rick-ecircuit/dvm-voltmeter-two-ranges-arduino/protoboard-assembly-connections.JPG

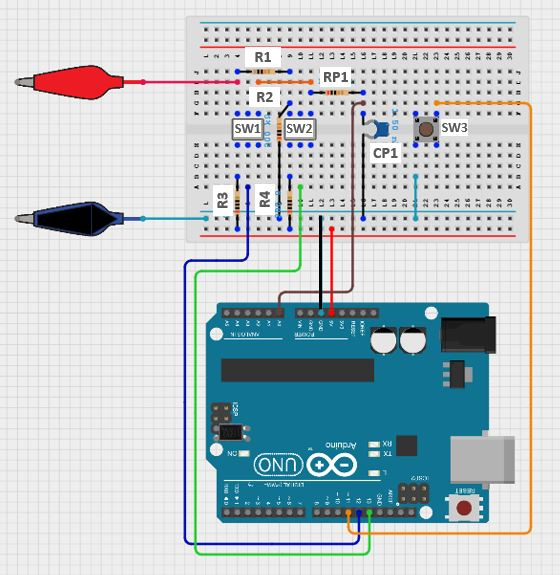
protoboard-assembly-connections.JPG
