rick-ecircuit/dvm-voltmeter-two-ranges-arduino/README.md

# DVM - Design and Build a Two Range Voltmeter using the Arduino.
## Intro

Get hands-on experience with a Digital Voltmeter using
- Resistor Divider
- PhotoMOS Switches
- Low-Pass Filter
- Ardiuno's UNO's ADC

<br>block diagram<br><br>
Check out an overview of the project.  
https://www.instructables.com/Make-a-Two-Range-Voltmeter-DVM-With-Auto-Manual-Ra/  

<br>Specifications
- Two voltage ranges: +4V and +20V.
- Manual (pushbutton) or Auto Range Selection.
- Accuracy
	- 4V Range: Verror = ±15mV ±1.5% of Reading
	- 20V Range: Verror = ±75mV ±1.5% of Reading  

*You can customize the hardware / software for a higher voltage range with the included Design Equations and Excel Calculator.*  

<br>Project Files
- Specifications
- Circuit schematic
- Design equations
- Error Budget Analysis
- Excel calculators
- SPICE simulations
- Flowhart and Arduino code
- Test forms and results tracker  

## Digital Voltmeter Tutorials
>Get Hands-On Experience with 5 Key Design Phases  
>www.ecircuitcenter.com/DVM1/DVM1_series.html

## Project File List
Block Diagram, Schematic, Assembly
- DVM1_block_1.png
- protoboard-schematic.jpg
- protoboard-assembly-connections.jpg

Design Equations
- DVM1_Design_Eqns.pdf

Excel Calculators
- DVM1_Circuit_Design1
- DVM1_Implementation_Strategy1
- DVM1_Offset_Gain_Errors1
- DVM1_-_EBA_Offset_Gain_Errors1

LTSPICE Simulations
- DVM1_basic1.asc
- DVM1_advanced1.asc

Ardiuno Code
- DVM1_flowchart1.jpg
- DVM1_initial_test1.ino
- DVM1_basic_voltmeter1.ino
- DVM1_basic_voltmeter_auto1.ino

Test Forms and Results Tracker
- DVM1_Simulation_Test_Tracker.xlsx
- DVM1_Prototype_Test_Tracker.xlsx

<br>Let me know what you find helpful or any other comments and suggestions. Thanks!  
www.ecircuitcenter.com/contact.htm

Have fun on your next learning / design / coding adventure!

Rick  
eCircuit Center  
https://ecircuitcenter.com/
