rick-ecircuit/dvm-voltmeter-two-ranges-arduino/DVM1_block_1.PNG

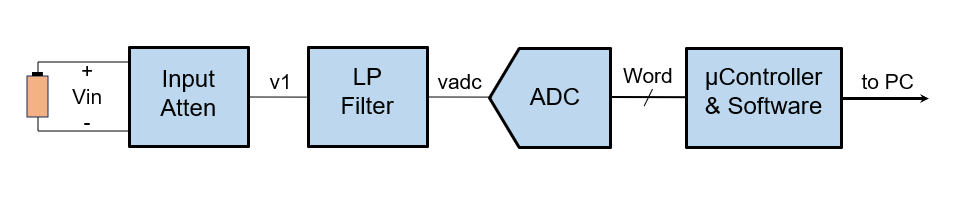
DVM1_block_1.PNG
