rick-ecircuit/dvm-voltmeter-two-ranges-arduino/DVM1_flowchart1.JPG

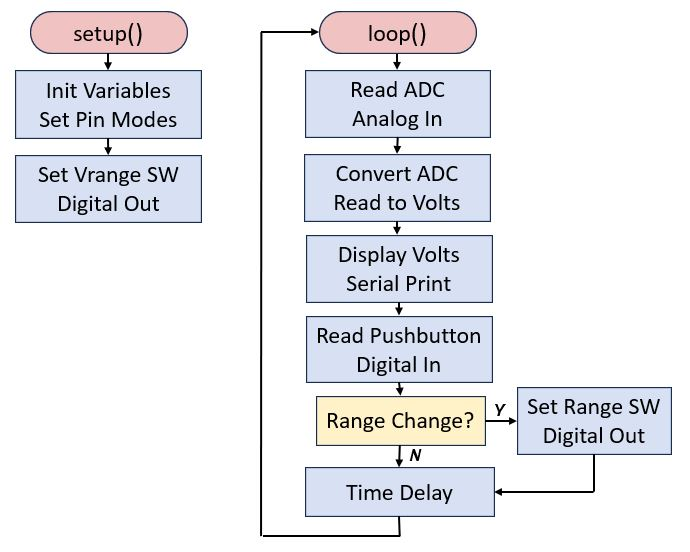
DVM1_flowchart1.JPG
