rick-ecircuit/dvm-voltmeter-two-ranges-arduino/protoboard-schematic.JPG

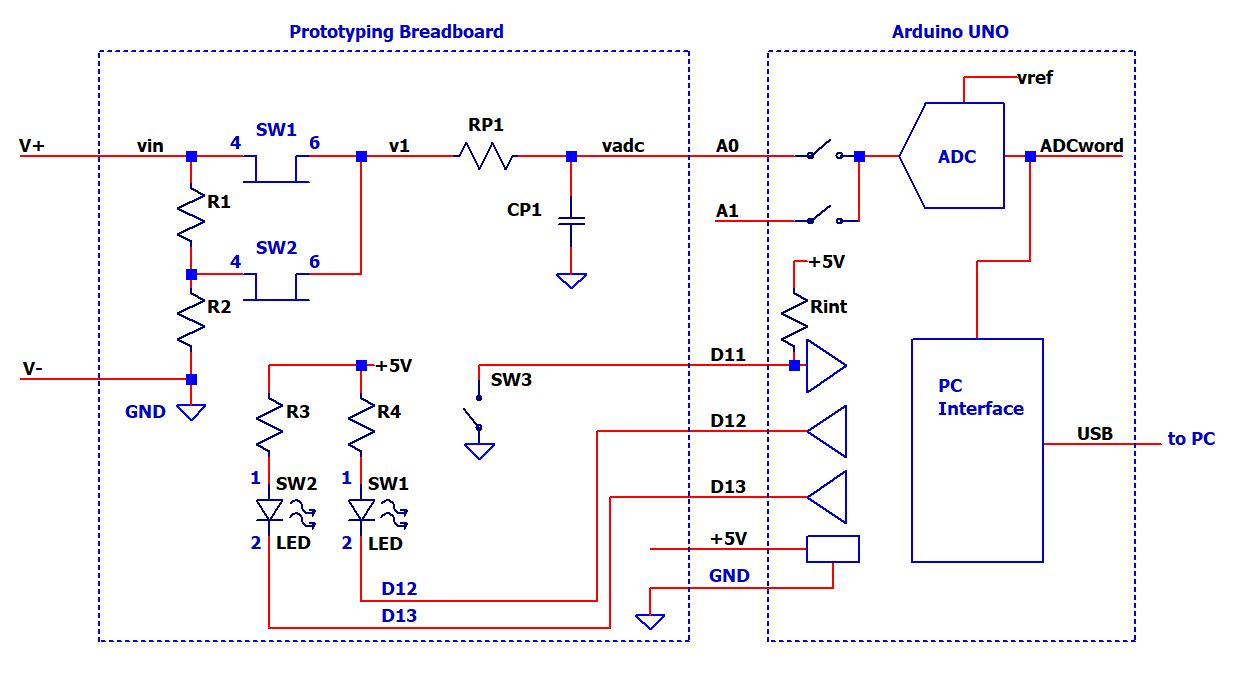
protoboard-schematic.JPG
