rick-ecircuit/dvm-voltmeter-two-ranges-arduino/DVM1_Parts_List.xlsx

DVM1 Parts List
Qty | Ref | Description | Part Number (Digi-key option)
1 |  | Arduino Uno Rev3 Microcontroller Board | A000066
1 |  | USB Cable Type A/B | generic
1 |  | Solderless Breadboard, SparkFun Electronics PRT-12002 | (1568-PRT-12002-ND)
1 pkg |  | Jumper Wires, Various Lengths, M to M, Adafruit Industries | (1528-2185-ND)
2 |  | Test leads, Gator to gator, BLK, RED | generic
2 | SW1,2 | SSR RELAY SPST-NO 500MA 0-60V | TLP592A(F) (TLP592AF-ND)
1 | R1 | RES 806K OHM 0.1%, ≥1/10W | any available
1 | R2 | RES 200K OHM 0.1%, ≥1/10W | any available
1 | RP1 | RES 200K OHM ≤5%, ≥1/10W | any available
1 | CP1 | CAP CER 0.15UF ≥50V, ≤10% X7R | any available
2 | R3,R4 | RES 1K OHM ≤5%, ≥1/10W | any available
1 | SW3 | Push Button, SparkFun Electronics COM-00097 | (1568-COM-00097-ND)
