rick-ecircuit/dvm-voltmeter-two-ranges-arduino/DVM1_advanced1.asc

B_ADC: bv; V=  int(   v(vsh)/v(vrefin) * (2**N)  )
CP1: cap; 0.15µF
Csh: cap; 20pF
DLED1: diode; DLED
DLED2: diode; DLED
R1: res; {R1}
R2: res; {R2}
R3: res; 1k
R4: res; 1k
Rmux: res; 10k
RP1: res; 200k
S_SH: sw; SH
V_D12: voltage; 0V
V_D13: voltage; 5V
V_SH: voltage; PULSE(0V 5V 300ms 10us 10us 1ms 400ms); AC 0V
VCC: voltage; 5V; AC 0V
VIN: voltage; PWL(0us 0V 1us 1.5V)
VLED1: voltage; 0V
VLED2: voltage; 0V
VREF: voltage; {Vref}
W_SW1: csw; VLED1; MOS
W_SW2: csw; VLED2; MOS
Named nets: 0, vin, v1, vsh, adc_word, vrefin, vadc, vcc, vled1, vd1, D12, vmux, v_sh, D13, vled2, vd2
DVM1 Level 2
V+
V-
.tran 0.4s
.param N=10 Vref=5.0V
Vrange   D12    D13
----------------------------
Low        0V      5V
High       5V      0V
ADC
.model SH VSWITCH(Ron=10k Roff=1e16 von=4V voff=1V)
.model DLED D( IS={Is} )
.model MOS ISWITCH(Ron=2 Roff=1e16 ion=3mA ioff=1mA)
A0
.param Vd = 1.1V Id=0.003 Is=Id/2.718**(Vd/0.0259)
ADC
LED
SWITCH
.param R1=800k R2=200k
DIVIDER
