rick-ecircuit/dvm-voltmeter-two-ranges-arduino/DVM1_basic1.asc

CP1: cap; 0.15µF
R1: res; 800k
R2: res; 200k
RP1: res; 200k
Rsw1: res; 1
Rsw2: res; 1e9
VIN: voltage; PWL(0us 0V 1us 1V); AC 1VAC
Named nets: 0, vin, v1, vadc, vdiv
DVM1 Basic Circuit
V+
V-
.tran 0s 0.4s
Vrange   Rsw1   Rsw2
----------------------------
Low        1           1e9
High       1e9       1
.ac dec 100 1Hz 100kHz
