rick-ecircuit/dvm-voltmeter-two-ranges-arduino/DVM1_Prototype_Test_Tracker.xlsx

Sheet: Visual, Resistance, Power Up
Bring-up Test - Visual, Resistance, Power-Up
Test / Conditions | Results / Comments | Notes, next steps, lessons learned | Pass/Fail?
Step 1 - Visual Inspection
Verify components installed correctly | If correct, then PASS |  | Fail
Verify jumper wires installed correctly | If correct, then PASS |  | Fail
Verify +5V, GND on Arduino UNO pins wired to +5V, GND busses on Breadboard | If correct, then PASS |  | Fail
Step 2 - Resistance Check
Measure resistance between +5V and GND | Enter measured value: If R > 100 ohms, then PASS |  | Fail
Step 3 - Power Up
Momentarily Apply Power (2-3 seconds) | If LED brightness normal, then PASS |  | Fail
Measure Voltage between +5V and GND | Enter measured value: If +5V +/-0.2V, then PASS |  | Fail
Place finger on components (Thermal Test) | If room temp or mildly warm, then PASS |  | Fail

Sheet: Software, Digital, Analog
Bring-up Test - Software, Digital Analog
Test / Conditions | Results / Comments | Notes, next steps, lessons learned | Pass/Fail?
Step 4 - Initial Software
Run Sketch file: DVM1_Initial_Test.ino | If ADCword and Vin values print continuously in Serial Monitor window, then PASS |  | Fail
Step 5 - Digital I/O Test
Check digital output voltages Set Vrange = 0 | Enter D12 value: Enter D13 value: If D12=0V and D13=5V, then PASS |  | Fail
Check digital output voltages Set Vrange = 1 | Enter D12 value: Enter D13 value: If D12=5V and D13=0V, then PASS |  | Fail
Check digital input voltages Do NOT press SW3 (pushbutton) | Enter D11 value: If D11=5V, then PASS |  | Fail
Check digital input voltages Press SW3 (pushbutton) | Enter D11 value: If D11=0V, then PASS |  | Fail
Step 6 - Analog Input
Check values in Serial Monitor vin = 3.3V Set Vrange = 0 (4V Range) | Enter Vin: If Vin=3.3V +/-0.1V, then PASS |  | Fail
Check values in Serial Monitor vin = 3.3V Set Vrange = 1 (20V Range) | Enter Vin: If Vin=3.3V +/-0.1V, then PASS |  | Fail

Sheet: Full Functional Test
Full Functional Test
Test / Conditions | Results / Comments | Notes, next steps, lessons learned | Pass/Fail?
4V Range Measurement (Default)
Run Sketch file: DVM1_Basic_Voltmeter.ino Vin = 3.3V No Pushbutton Press | Enter ADCword: Enter Vin: If Vin=3.3V +/-0.1V and ADCword=676+/-15, then PASS |  | Fail
20V, 4V Range Changes
No Pushbutton Press (4V Range) | Observe variable buttonState If buttonState = 1 and Vrange = 0 then PASS |  | Fail
Press Pushbutton (20V Range) | Observe variable buttonState If buttonState transitions from 1 to 0, and Vrange transitions from 0 to 1, then PASS |  | Fail
(continued) | Enter ADCword: Enter Vin: If Vin=3.3V +/-0.1V and ADCword=135+/-5, then PASS |  | Fail
Press Pushbutton (4V Range) | Observe variable buttonState If buttonState transitions from 1 to 0, and Vrange transitions from 1 to 0, then PASS |  | Fail
(continued) | Enter ADCword: Enter Vin: If Vin=3.3V +/-0.1V and ADCword=676+/-15, then PASS |  | Fail

Sheet: Accuracy Test
Accuracy Test
 |  | Enter
 |  | Calc
 |  | Voltmeter Measurent | Accuracy Spec Limit |  |  | Ref Voltmeter Measurement | Reference Uncertainty |  |  | Error Measured | Accuracy (includes uncertainty) |  | Decision Rule
Specification | Notes / Comments | Vm | Offset error | Gain error (%) | Max Error Spec Limit | Vm_ref | Offset error | Gain error (%) | Max Error Ref Std | Vm-Vm_ref | | Vm-Vm_ref | + | Max Error Ref Std | | Accuracy Spec Limit (repeated here) | if Accuracy < Spec Limit, then P, else F
Accuracy Test, 4V Range Vin = 3.3V, Vrange=0 | Fluke 87V Multimeter 0.1% R1, R2 | 3.286 | 0.015 | 1.5 | 0.064 | 3.307 | 0.001 | 0.05 | 0.003 | -0.021 | 0.024 | 0.064 | Pass
Accuracy Test, 20V Range Vin = 5.0V, Vrange=1 | Fluke 87V Multimeter 0.1% R1, R2 | 4.955 | 0.075 | 1.5 | 0.149 | 5.018 | 0.001 | 0.05 | 0.004 | -0.063 | 0.067 | 0.149 | Pass
Accuracy Test, 4V Range Vin = 3.3V, Vrange=0 | EX330 Multimeter 0.1% R1, R2 | 3.286 | 0.015 | 1.5 | 0.064 | 3.309 | 0.002 | 1.0 | 0.035 | -0.023 | 0.058 | 0.064 | Pass
Accuracy Test, 20V Range Vin = 5.0V, Vrange=1 | EX330 Multimeter 0.1% R1, R2 | 4.955 | 0.075 | 1.5 | 0.149 | 5.060 | 0.020 | 1.0 | 0.071 | -0.105 | 0.176 | 0.149 | Fail
