rick-ecircuit/dvm-voltmeter-two-ranges-arduino/DVM1_Simulation_Test_Tracker.xlsx

Sheet: Basic
Basic SPICE Simulation
Test List |  | Enter |  | Alt-Enter to start new line in cell
 |  | Calc
Specification | Inputs / Conditions | Outputs / Measurements | Params / Calc / Notes | Expected Value | Error Limit | Units | Limit Lo | Limit Hi | Measured Value | P/F?
INPUT DIVIDER
Input Divider, Gain (K), 20V | vin=20V Rsw1=1e9, Rsw2=1 TRAN simulation | measure vadc final value | K=1/5 vadc=Vin*K | 4.00 | 2.0 | % | 3.92 | 4.08 | 0.000 | Fail
Input Divider, Gain (K), 4V | vin=4V Rsw1=1, Rsw2=1e9 TRAN simulation | measure vadc final value | K=1 vadc=Vin*K | 4.00 | 2.0 | % | 3.92 | 4.08 | 0.000 | Fail
LOW PASS FILTER
LP Filter, Risetime (tr63) | vin=1V Rsw1=1, Rsw2=1e9 TRAN simulation | measure vadc, find time where vadc rises to 63% | tr63=0.030s K=1, vadc=Vin*K*0.63=0.63V | 0.030 | 5.0 | % | 0.0285 | 0.0315 | 0.00000 | Fail
LP Filter, Bandwidth -3dB (fc) | vin=1VAC Rsw1=1, Rsw2=1e9 AC simulation | measure vadc, find freq fc where vadc crosses -3dB | H(fc)=0.707 or -3dB | 5.300 | 5.0 | % | 5.03 | 5.57 | 0.000 | Fail
LP Filter, Atten at 60Hz (H(60Hz) | vin=1VAC Rsw1=1, Rsw2=1e9 AC simulation | measure vadc, find MAGNITUDE at 60 Hz | H(fc)=fc/fmeas = 5.3/60 = 20*log(5.3/60) | -21.08 | 0.5 | dB | -21.58 | -20.58 | 0.00 | Fail

Sheet: Advanced
Advanced SPICE Simulation
Test List |  | Enter |  | Alt-Enter to start new line in cell
 |  | Calc
Specification | Inputs / Conditions | Outputs / Measurements | Params / Calc / Notes | Expected Value | Error Limit | Units | Limit Lo | Limit Hi | Measured Value | P/F?
BATTERY MEASURE
Battery Measure, 1.5V (adc_word) | vin=1.5V D12=0V, D13=5V (K=1) TRAN simulation | measure adc_word at final time | adc_word = vin*K/Vrefin*1024 | 307.2 | 2.0 | % | 301.056 | 313.344 | 0.0 | Fail
Battery Measure, 9V (adc_word) | vin=9V D12=5V, D13=0V (K=0.2) TRAN simulation | measure adc_word at final time | adc_word = vin*K/Vrefin*1024 | 368.64 | 2.0 | % | 361.2672 | 376.0128 | 0.0 | Fail
PHOTOMOS RELAY
PhotoMOS Relay, LED Current (Iled) | vcc=5V, Vled=1.1V D12=0V, D13=0V TRAN simulation | measure I(LED1) at any time. | Iled = (Vcc-Vled)/Rled | 0.00390 | 5.0 | % | 0.00370 | 0.00409 | 0.00000 | Fail
