rick-ecircuit/dvm-voltmeter-two-ranges-arduino/DVM1_basic_voltmeter_auto1.ino

/*
  DVM1 Basic with Auto Range

  Read ADC and convert to voltage at R divider input.
  Display Vinput at PC screen
  Auto Select Vrange depending on input level
*/

int Vrange = 0;               // 0 - 4V Range, 1 - 20V Range
int ADCword = 0;              // ADC value (counts)
float Vinput = 0;             // input voltage (V)

// resistor divider
float R1 = 825000;            // Rdivider
float R2 = 200000;            // Rdivider
float Kdiv = 1;               // gain

// digital bits
const int SW1 = 12;           // sw1 control
const int SW2 = 13;           // sw2 control
const int buttonPin = 11;     // pushbutton input

// the setup routine runs once *****************************
void setup() { 
  // initialize serial communication at 9600 bits per second:
  Serial.begin(9600);

  // configure digital pins
  pinMode(SW1, OUTPUT);               // set as output
  pinMode(SW2, OUTPUT);               // set as output
  pinMode(buttonPin, INPUT_PULLUP);   // set as input

  // set voltage range manually with variable
  Vrange = 0;    // 0 - 4V Range, 1 - 20V Range

  // set Vrange switches at R Divider
  if (Vrange == 0) { // 4V Range
    // sw to straight in
    digitalWrite(SW1, LOW); // sw1 ON
    digitalWrite(SW2, HIGH); // sw2 OFF
  }
  else { // 25V Range
    // sw to divider tap
    digitalWrite(SW1, HIGH); // sw1 OFF
    digitalWrite(SW2, LOW); // sw2 ON
  }

}


// the loop routine runs continuously **********************
void loop() {

  // read analog input from ADC at pin A0
  ADCword = analogRead(A0);
  
  // calc input divider scaling
  if (Vrange == 0) {  // 4V Range
    Kdiv = 1;
  }
  else {              // 20V Range
    Kdiv = R2/(R1+R2);
  }

  // convert ADC counts to input voltage
  // Vinput = ADCvalue * Vref/2^N * 1/Kdiv
  Vinput = ADCword * (5.0 / 1024.0) * 1/Kdiv ;

  
  // Auto Range - check input level and set range 
  if (Vinput > 4.90) { // set to HIGH Range
    Vrange = 1; 
  }
  if (Vinput < 4.85) {  // set to LO Range
    Vrange = 0;
  }

  // set Vrange switches at R Divider
  if (Vrange == 0) { // 4V Range
    // sw to straight in
    digitalWrite(SW1, LOW);   // sw1 ON
    digitalWrite(SW2, HIGH);  // sw2 OFF
  }
  else { // 20V Range
    // sw to divider tap
    digitalWrite(SW1, HIGH);  // sw1 OFF
    digitalWrite(SW2, LOW);   // sw2 ON
  }

  // time delay (ms) for approx 4 readings per second
  delay(250); 

  // print out the values to computer as ASCII
 
  Serial.print("Vinput,ADCword,Vrange:\t");
  Serial.print(Vinput,3);
  Serial.print("\t"); 
  Serial.print(ADCword);
  Serial.print("\t"); 
  Serial.println(Vrange);
}
