rick-ecircuit/dvm-voltmeter-two-ranges-arduino/(commit log)

2025-09-15 Upload original design files
    [DVM1_-_EBA_Offset_Gain_Errors1.xlsx, DVM1_Circuit_Design1.xlsx, DVM1_Implementation_Strategy1.xlsx, DVM1_Offset_Gain_Errors1.xlsx, DVM1_Prototype_Test_Tracker.xlsx, DVM1_Simulation_Test_Tracker.xlsx]
2025-09-23 add parts list and code for auto range
    [DVM1_Parts_List.xlsx]
